okwaku/LTDS/ltds-github-repository/cad/top3 (1).STL

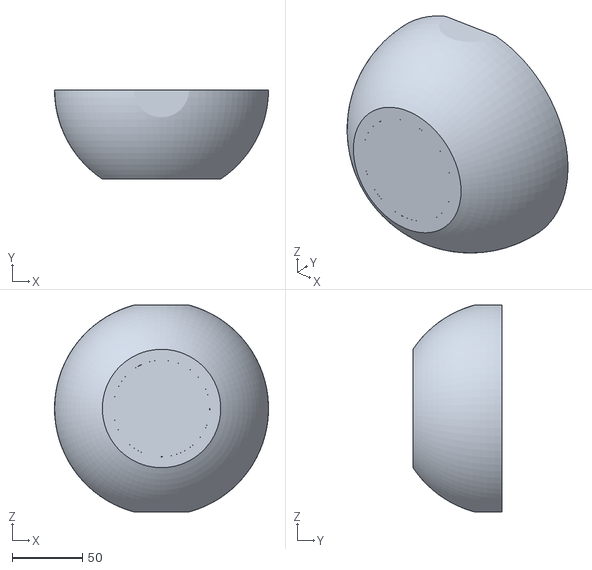
[picture p8: CAD file, 2026-06-26]
ltds-github-repository/cad/top3 (1).STL
152.3 x 63.5 x 147.3
